shima091824-collab/pokota-tools/gps-cat-tracker/BOM.md

# GPS Cat Tracker LoRa v3n — BOM (Bill of Materials)

> **基板**: 30 × 35 mm（充電回路搭載版・503035バッテリー対応）
> **通信**: E220-900T22S(JP) LoRa 920MHz 技適済 (001-P01730)
> **設計ファイル**: `lora-30x35-v3n.kicad_pcb`
> **ピン配置**: 全部品データシート＋KiCadライブラリで確認済み (2026-05-26)
> **v3n追加 (2026-05-28)**: USB-C充電回路 + TP4056 + MSK12C02電源SW + LED×2

---

## v3n 変更点（v3m からの追加）

| 追加内容 | 詳細 |
|---|---|
| 基板サイズ | 30×28mm → **30×35mm**（バッテリーと同フットプリント） |
| USB-C充電 | SMDエッジマウント（VBUS/GND/CC1/CC2） |
| 充電IC | TP4056 SOT-23-8（5kΩ PROG → 200mA充電） |
| 電源SW | MSK12C02 SPDT（BATT+とE220 VCCを切断） |
| 充電LED | 赤（充電中）・青（充電完了）各0402 |
| CC抵抗 | R5/R6 5.1kΩ × 2（USB-C CC1/CC2プルダウン） |
| バッテリー | **503035 LiPo（5×30×35mm 推定350mAh）** |

---

## ⚠️ v3 Plan-B 変更点（v2からの修正）

| 変更点 | v2（GPS無し） | v3 Plan-B |
|---|---|---|
| ボードサイズ | 30×22mm | **30×28mm**（GPS搭載のため拡大） |
| GPS | プレースホルダのみ | **MAX-M8Q 実装**（9.7×10.1mm） |
| GPS footprint | 4.1×3.1mm（**誤り**） | **9.7×10.1mm**（データシート実測値） |
| GPSパッドピッチ | 0.35mm（推定、誤り） | **1.1mm**（データシートTable21 E値） |
| 重量（目安） | 約5〜6g | **約8〜9g** |
| バッテリ寿命 | LoRaのみ約214日 | **GPS+LoRa 約10日** |

### v2からの継続事項（変更なし）
| 項目 | 内容 |
|---|---|
| E220ピン配置 | データシート確認済み：短辺22ピンDFN |
| ATtiny3226ピン配置 | データシート確認済み：VQFN-20 セクション2.3 |
| GPS電圧 | 3.3V直接接続（VIO_SEL=開放で3.3Vモード） |
| 充電回路 | 削除済み（外付け充電器で充電） |
| 電源 | E220 VDD(pin15)=3.3V出力を活用（LDO不要） |
| GPSアンテナ | IPEX/U.FLコネクタ経由で外付けGPSパッチアンテナ接続 |

---

## 主要部品

### 既存部品（v3m から継続）

| Ref | 部品名 | 型番 | 調達先候補 | 数量 | 単価(目安) | 備考 |
|-----|---|---|---|---|---|---|
| U1 | LoRaモジュール | E220-900T22S(JP) | 秋月/Amazon/千石 | 1 | ¥2,500 | 技適✅ 001-P01730, 26×16mm DFN-22 |
| U2 | MCU | ATtiny3226-MFR | Mouserほか | 1 | ¥220 | VQFN-20 3×3mm, UART×2, 1.8-5.5V |
| U3 | GPS | MAX-M8Q-00B | Mouserほか | 1 | ¥800 | **9.7×10.1mm LCC-18**, 3.3V対応, -148dBm |
| J1 | バッテリコネクタ | JST-GH 1.25mm 2P | 秋月 | 1 | ¥60 | SMD横差し |
| C1–C4 | コンデンサ 100nF 0402 | — | JLCPCB Basic | 4 | ¥3 | 電源デカップリング |
| C5 | コンデンサ 1μF 0402 | — | JLCPCB Basic | 1 | ¥5 | 3.3Vバルクキャップ |
| R1 | 抵抗 10kΩ 0402 | — | JLCPCB Basic | 1 | ¥2 | E220 AUXプルアップ（オプション） |

### v3n 追加部品

| Ref | 部品名 | 型番 | 調達先候補 | 数量 | 単価(目安) | 備考 |
|-----|---|---|---|---|---|---|
| J2 | USB-C充電コネクタ | TYPE-C-31-M-12 等 | AliExpress/秋月 | 1 | ¥100 | SMDエッジマウント |
| U4 | 充電IC | TP4056 | AliExpress/JLCPCB | 1 | ¥50 | SOT-23-8, 5V入力→LiPo充電 |
| SW1 | 電源スイッチ | MSK12C02 | AliExpress | 1 | ¥30 | SPDT スライド, 4×3mm |
| LED1 | 充電中LED（赤） | 0402 RED | JLCPCB Basic | 1 | ¥3 | 充電中点灯 |
| LED2 | 充電完了LED（青） | 0402 BLUE | JLCPCB Basic | 1 | ¥3 | 満充電で点灯 |
| R2 | PROG抵抗 | 5kΩ 0402 | JLCPCB Basic | 1 | ¥2 | 充電電流 1000/5000=**200mA** |
| R3 | LED電流制限 | 330Ω 0402 | JLCPCB Basic | 1 | ¥2 | LED1用 |
| R4 | LED電流制限 | 330Ω 0402 | JLCPCB Basic | 1 | ¥2 | LED2用 |
| R5 | CC1プルダウン | 5.1kΩ 0402 | JLCPCB Basic | 1 | ¥2 | USB-C規格準拠（必須） |
| R6 | CC2プルダウン | 5.1kΩ 0402 | JLCPCB Basic | 1 | ¥2 | USB-C規格準拠（必須） |
| C6 | バイパスコンデンサ | 100nF 0402 | JLCPCB Basic | 1 | ¥3 | TP4056 VCC直近 |
| — | LiPoバッテリー | **503035** | AliExpress/Amazon | 1 | ¥700 | 5×30×35mm 推定300〜400mAh |

---

## 電源アーキテクチャ（LDO不要！）

```
LiPo 3.7V ──→ J1(BATT+) ──→ E220 VCC (pin10, 2.2-5.5V対応)
                                    │
                              E220内蔵LDO
                                    │
                              E220 VDD (pin15) = 3.3V出力（最大100mA）
                                    │
                    ┌───────────────┼───────────────┐
                    ↓               ↓               ↓
              ATtiny VDD(pin4)  GPS VCC(pin8)   GPS V_IO(pin7)
              ATtiny電源(3.3V)  GPS電源(3.3V)   GPS IOレベル(3.3V)
```

**GPS VIO_SEL (pin15) = 開放 → V_IO = VCC = 3.3V**（3.3Vモード自動選択）

---

## 確認済みピン配置（全てデータシート実測値）

### E220-900T22S(JP) — データシート Rev2.1.1 セクション3.1

| ピン | 信号名 | 接続先 |
|---|---|---|
| 1-3 | AGND | GND（RF側） |
| 4 | GND | GND |
| 5 | M0 | ATtiny PA4 (VQFN pin5) |
| 6 | M1 | ATtiny PA5 (VQFN pin6) |
| 7 | RXD | ATtiny PB2/USART0-TxD (VQFN pin12) |
| 8 | TXD | ATtiny PB3/USART0-RxD (VQFN pin11) |
| 9 | AUX | ATtiny PA6 (VQFN pin7)、入力 |
| 10 | VCC | BATT+ (3.7V LiPo) |
| 11 | GND | GND |
| 12 | SWDIO | 未接続（FW更新用） |
| 13 | SWGND | GND（FW更新時のみ） |
| 14 | SWCLK | 未接続（FW更新用） |
| 15 | VDD | **3.3V出力** → ATtiny/GPS電源 |
| 16-18 | NC | 開放 |
| 19 | GND | GND |
| 20 | AGND | GND（RF側） |
| 21 | ANT | IPEXコネクタ（アンテナ接続） |
| 22 | AGND | GND（RF側） |

### ATtiny3226 VQFN-20 — DS40002345A セクション2.3

| ピン | 信号名 | 接続先 |
|---|---|---|
| 1 | PA2 | 未使用 |
| 2 | PA3 | 未使用 |
| 3 | GND | GND |
| 4 | VDD | 3.3V（E220 VDD） |
| 5 | PA4 | E220 M0 (pin5) |
| 6 | PA5 | E220 M1 (pin6) |
| 7 | PA6 | E220 AUX (pin9) |
| 8 | PA7 | 未使用 |
| 9 | PB5 | 未使用 |
| 10 | PB4 | 未使用 |
| 11 | PB3/USART0-RxD | E220 TXD (pin8) |
| 12 | PB2/USART0-TxD | E220 RXD (pin7) |
| 13 | PB1 | 未使用 |
| 14 | PB0 | 未使用 |
| 15 | PC0 | 未使用 |
| 16 | PC1/USART1-RxD★ | GPS TXD (pin2) ★PORTMUX要設定 |
| 17 | PC2/USART1-TxD★ | GPS RXD (pin3) ★PORTMUX要設定 |
| 18 | PC3 | 未使用 |
| 19 | PA0/UPDI | プログラミング端子 |
| 20 | PA1 | 未使用 |
| EP | GND | GND（熱パッド、接続必須） |

★PORTMUX設定: `PORTMUX.USARTROUTEA |= PORTMUX_USART1_ALT1_gc;` （USART1をPC1/PC2に割り当て）

### MAX-M8Q LCC-18 — 9.7×10.1mm（データシート UBX-15031506-R06 Table11確認済み）

> **パッド仕様（KiCadオフィシャルライブラリ ublox_MAX.kicad_mod + DS確認済み）**
> - 9パッド/辺（長辺10.1mm = Y方向側）
> - ピッチ E=1.1mm（DS Table11確認済み）
> - 端から1番目パッドまで D=0.65mm（DS確認済み）
> - パッドサイズ: **1.8mm × 0.8mm**（角パッド1,9,10,18は1.8mm × 0.7mm）
> - パッドX位置: ±4.75mm（KiCadライブラリ実測値）
> - **EP（サーマルパッド）なし**（LCC-18は側面パッドのみ）
> - 動作電圧: VCC/VCC_IO = 2.7〜3.6V（typ 3.0V）→ 3.3V接続✓
> - 重量: **0.6g**（DS確認済み）

| ピン | 信号名（M8Q） | 接続先 |
|---|---|---|
| 1 | GND | GND |
| 2 | TXD | ATtiny PC1/USART1-RxD (pin16) |
| 3 | RXD | ATtiny PC2/USART1-TxD (pin17) |
| 4 | TIMEPULSE | 未使用（開放） |
| 5 | EXTINT | 未使用（開放） |
| 6 | V_BCKP | VCC(3.3V)に接続（RTC維持） |
| 7 | **VCC_IO** | 3.3V（E220 VDD）※M8QではV_IOではなくVCC_IO |
| 8 | VCC | 3.3V（E220 VDD） |
| 9 | RESET_N | 未使用（開放）内部プルアップあり |
| 10 | GND | GND |
| 11 | RF_IN | IPEX/U.FLコネクタ → 外付けGPSパッチアンテナ |
| 12 | GND | GND |
| 13 | LNA_EN | 未使用（開放）※M8Q/Cでアンテナ制御可能 |
| 14 | VCC_RF | 未使用（開放） |
| 15 | **Reserved** | **開放（M8Qでは未接続）** ※M10SのVIO_SELとは全く別！ |
| 16 | SDA | 未使用（開放） |
| 17 | SCL | 未使用（開放） |
| 18 | SAFEBOOT_N | 未使用（開放）内部プルアップあり |

**⚠️ M8QとM10Sの違い:**
- pin7: M8Q=**VCC_IO** / M10S=V_IO（どちらも3.3V接続）
- pin15: M8Q=**Reserved**（開放）/ M10S=VIO_SEL（開放で3.3V選択）
- 動作電圧: M8Q=2.7〜3.6V / M10S=1.71〜1.89V（VIO_SEL=openで3.3V I/Oモード）

---

## ★ 発注前の必須確認事項

- [x] **GPSフットプリント寸法確認済み**
  - DS Table11: A=10.1mm, B=9.7mm, E=1.1mm(ピッチ), D=0.65mm(端〜1番パッド) 確認済み
  - KiCad公式ライブラリ(ublox_MAX.kicad_mod): pad=1.8×0.8mm, X=±4.75mm 確認済み
  - EP（サーマルパッド）なし 確認済み
- [ ] **IPEX/U.FLコネクタをKiCadに手動追加**（GPS pin11=RF_IN接続用）
  - 推奨: Hirose U.FL-R-SMT-1(10) または同等品
  - 配置: GPS左辺(pin11)近傍、基板左寄り
- [ ] KiCad DRC（`検査 > デザイン ルール チェッカー`）エラーゼロ確認
- [ ] E220フットプリント: パッドピッチ1.27mm確認済み（データシートより）✓
- [ ] ATtiny3226 QFN-20: 0.5mmピッチ → **外注推奨**（手はんだ難）
- [ ] MAX-M8Q LCC-18: 1.1mmピッチ → **外注推奨**（細密）
- [ ] GPS外付けアンテナ選定・調達（1575.42MHz パッシブGPS対応）
  - 候補: Taoglas FXP.35 フレキシブルパッチアンテナ（小型軽量）
  - または: 汎用GPSパッチアンテナ + U.FLケーブル（100〜200円）

---

## PCB発注（JLCPCB）

| 項目 | 仕様 |
|---|---|
| 基板サイズ | 30 × 28 mm |
| 層数 | 2層 |
| 厚さ | 0.8mm（軽量化） |
| 銅箔 | 1oz |
| 表面仕上げ | HASL（鉛なし） |
| ソルダーマスク | 緑 |
| 枚数 | 5枚（最小ロット） |
| **PCB代（目安）** | **約$2〜3（OCS NEP送料込み）** |

**アップロードファイル**: `gerber-v3b/lora-30x28-v3b-gerber.zip`

---

## バッテリ（別途調達）

| 品名 | 寸法 | 価格 |
|---|---|---|
| LiPo 300mAh 3.7V | 5×30×28mm以内 | ¥600〜900 |

外付けUSBchargerでバッテリーを充電

---

## 重量・バッテリ寿命

| 項目 | 値 | 出典 |
|---|-----|---|
| PCB重量目安 | 約3.5g（30×28mm） | 推定 |
| GPS モジュール | **0.6g** | DS Table11実測値 |
| バッテリ（300mAh） | 約5g | 仕様 |
| アンテナ+U.FLケーブル | 約1g | 推定 |
| **合計** | **約10〜11g** | |

### 消費電流（MAX-M8Q、3.0V動作）— DS Table10実測値

| モード | 電流 | 条件 |
|---|---|---|
| GPS 取得中 | **26mA** | Acquisition（start〜first fix） |
| GPS 連続追跡 | **23mA** | Tracking Continuous mode |
| GPS 省電力追跡 | **6.2mA** | Tracking Power Save 1Hz mode |
| LoRa 送信 | 43mA | 13dBm（E220 DS） |
| スリープ | <7.5µA | ATtiny3226(<5µA) + E220 DeepSleep(2.5µA) |

### バッテリ寿命計算（30分間隔、300mAh）

| GPS動作モード | 計算式 | 寿命 |
|---|---|---|
| 連続追跡（60秒GPS+2秒LoRa） | 26mA×15s + 23mA×45s + 43mA×2s = 20.5mAh/日 | **約14日** |
| 省電力1Hz（60秒GPS+2秒LoRa） | 26mA×10s + 6.2mA×50s + 43mA×2s = 8.9mAh/日 | **約34日** |

> 省電力モードはATtinyからGPS EXTINT(pin5)でコントロール可能（PowerSave設定）

---

## ホーム受信機（別途構築）

猫が帰宅/外出した際のLoRa信号受信用

| 部品 | 型番 | 価格 |
|---|---|---|
| Raspberry Pi Zero W | — | ¥2,000〜 |
| E220-900T22S(JP) | 同型 | ¥2,500 |
| USBシリアル変換 | CP2102など | ¥500 |
| 外付けアンテナ | 920MHz対応 | ¥500 |
| **合計** | | **¥5,500〜** |

---

## 総コスト（初回）

| 項目 | 金額 |
|---|---|
| JLCPCB PCB（5枚） | ¥450 |
| E220-900T22S(JP) × 1 | ¥2,500 |
| ATtiny3226 × 1 | ¥220 |
| MAX-M8Q × 1 | ¥800 |
| JST-GH + コネクタ | ¥60 |
| パッシブ部品一式 | ¥100 |
| GPSチップアンテナ | ¥200〜 |
| バッテリ 300mAh | ¥700 |
| はんだ付け外注（GPS/MCU） | ¥3,000〜 |
| **合計（初回）** | **約¥8,000〜** |

---

*設計: Claude Code / Anthropic — v3c Plan-B 2026-05-26*
*全ピン配置・footprint寸法はデータシート+KiCadオフィシャルライブラリで確認済み。*
*MAX-M8Q DS: UBX-15031506-R06 | KiCad lib: ublox_MAX.kicad_mod | E220 DS: Rev2.1.1*
