shima091824-collab/pokota-tools/traccar/templates/export/devices.xlsx

Report type: | Devices
Name | Unique ID | Phone | Model | Contact | Status | Last Update | Address
${item.device.name} | ${item.device.uniqueId} | ${item.device.phone} | ${item.device.model} | ${item.device.contact} | ${item.device.status} | ${dateTool.format("YYYY-MM-dd HH:mm:ss", item.device.lastUpdate, locale, timezone)} | ${item.position.address}
