shima091824-collab/pokota-tools/lte-m-cat-tracker/kicad/_restore_backup_2026-06-12T14-10-30-185/lte-m-cat-tracker.kicad_pcb

## KiCad design lte-m-cat-tracker/kicad/_restore_backup_2026-06-12T14-10-30-185/lte-m-cat-tracker.kicad_pcb (2026-06-12)

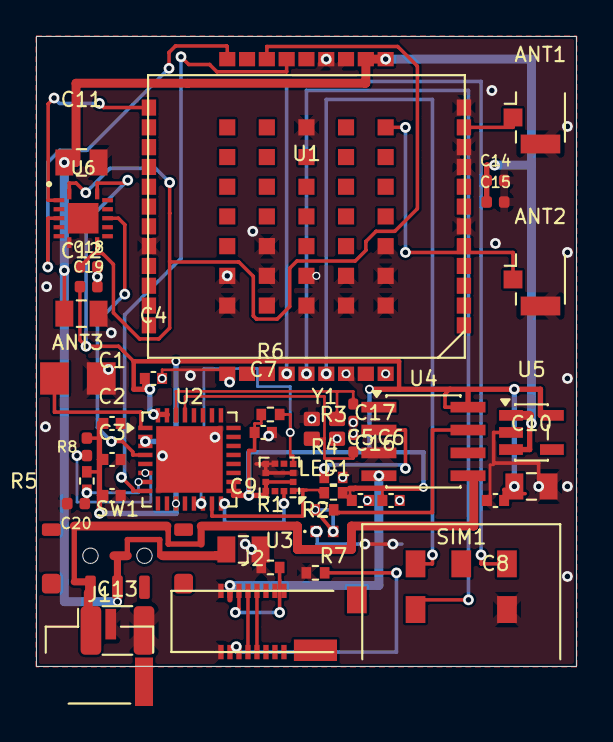
[picture p1: board lte-m-cat-tracker.kicad_pcb from above]

Board: 2 copper layers, 30.0 x 35.0 mm, 43 parts (0 on the bottom side), 34 nets.

Parts:
ANT1: U.FL-LTE
ANT2: U.FL-GNSS
ANT3: RFANT3216120A5T; ChipAntenna_1206
C1, C2, C3, C4, C5, C6, C7, C8: 100nF
C9, C10, C11, C12: 10uF
C13: 100uF_6.3V_PolymerAl; C_1210_3225Metric
C14, C15, C18, C19, C20: 100nF; C_0402
C16, C17: 18pF
J1: JST-GH-1.25mm-2P
J2: USB-C-16P
LED1: RED
R1, R2: 5.1k
R3: 3.3k
R4: 1k
R5: 10k
R6, R7: 4.7k
R8: 10k; C_0402
SIM1: SMN-305
SW1: MSK12C02-HB
U1: SIM7080G-M
U2: ESP32-C3
U3: LIS2DW12TR
U4: TP4056
U5: XC6220B331MR-G
U6: TXB0104RGYR; TXB0104_RGY14
Y1: 7D040000M01 40MHz 12pF

Connections:
+3.3V: C1.1, C2.1, C3.1, C4.1, C5.1, C6.1, C7.1, C8.1, C10.1, C19.1, R5.2, R6.1, R7.1, R8.2, U2.2, U2.3, U2.11, U2.17, U2.18, U2.31, U2.32, U3.2, U3.9, U3.10, U4.8, U5.5, U6.14
ACCEL_INT1: U2.16, U3.12
CC1: J2.A5, R1.2
CC2: J2.B5, R2.2
CHIP_EN: C20.1, R5.1, U2.7
CHRG: R4.2, U4.7
ESP_GPIO2: R8.1, U2.6
GND: ANT1.2, ANT2.2, ANT3.2, C1.2, C2.2, C3.2, C4.2, C5.2, C6.2, C7.2, C8.2, C9.2, C10.2, C11.2, C12.2, C13.2, C14.2, C15.2, C16.1, C17.2, C18.2, C19.2, C20.2, J1.2, J2.A1, J2.B1, LED1.1, R1.1, R2.1, R3.2, SIM1.5, U1.8, U1.13, U1.19, U1.21, U1.27, U1.30, U1.31, U1.33, U1.36, U1.37, U1.45, U1.63, U1.66, U1.67, U1.69, U1.70, U1.71, U1.72, U1.73, U1.74, U1.75, U1.76, U1.77, U2.33, U3.3, U3.6, U3.7, U3.8, U4.3, U5.2, U6.7, U6.15, Y1.2, Y1.4
GNSS_ANT: ANT2.1, U1.68
I2C_SCL: R7.2, U2.15, U3.1
I2C_SDA: R6.2, U2.14, U3.4
LED_ANODE: LED1.2, R4.1
LTE_ANT: ANT1.1, U1.32
PROG: R3.1, U4.2
SIM_CLK: SIM1.3, U1.16
SIM_DATA: SIM1.2, U1.15
SIM_PWRKEY: U1.39, U2.8
SIM_RST: SIM1.4, U1.17
SIM_RXD: U1.2, U6.3
SIM_RXD_33: U2.28, U6.12
SIM_STATUS: U1.42, U6.4
SIM_STATUS_33: U2.4, U6.11
SIM_TXD: U1.1, U6.2
SIM_TXD_33: U2.27, U6.13
SIM_VDD: SIM1.1, U1.18
USB_DN: J2.A7, J2.B7, U2.25
USB_DP: J2.A6, J2.B6, U2.26
VBAT: C13.1, J1.1, SW1.1, U4.5
VBAT_SW: C9.1, C11.1, C12.1, C14.1, C15.1, SW1.2, U1.34, U1.35, U5.1, U5.3
VDD_EXT: C18.1, U1.40, U6.1, U6.8
VUSB: J2.A4, U4.4
WIFI_ANT: ANT3.1, U2.1
XTAL_N: C16.2, U2.29, Y1.1
XTAL_P: C17.1, U2.30, Y1.3
