shima091824-collab/pokota-tools/gps-cat-tracker/lora-30x28-v3m_netted.kicad_pcb

## KiCad design gps-cat-tracker/lora-30x28-v3m_netted.kicad_pcb (2026-06-05)

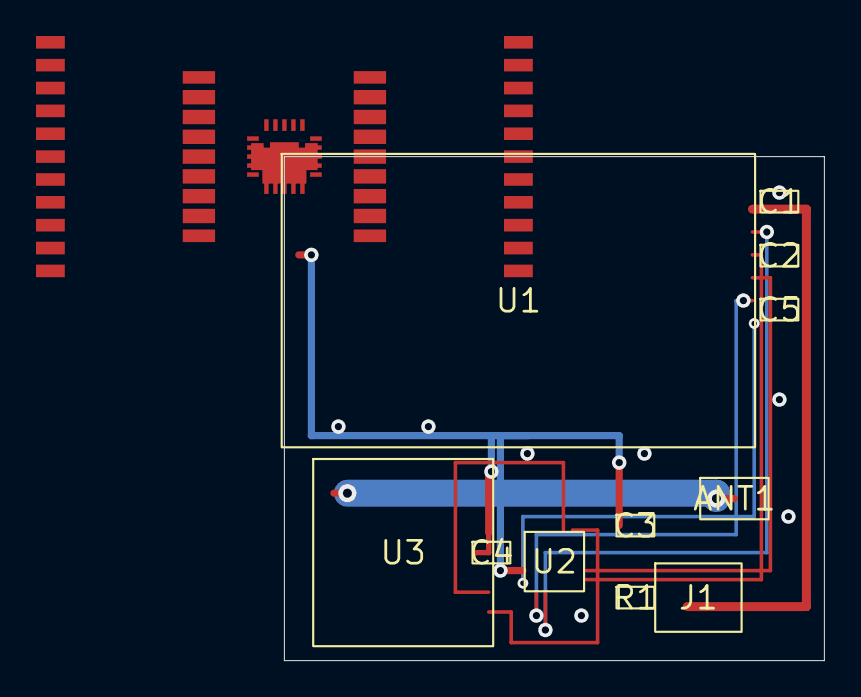
[picture p2: board lora-30x28-v3m_netted.kicad_pcb from above]

Board: 2 copper layers, 30.0 x 28.0 mm, 11 parts (0 on the bottom side), 9 nets.

Parts:
ANT1: U.FL-R-SMT_IPEX
C1, C2, C3, C4: 100nF
C5: 1uF
J1: JST-GH_1.25mm_2P
R1: 10k
U1: E220-900T22S(JP)
U2: ATtiny3226-MFR_VQFN20
U3: MAX-M8Q-00B_LCC18

Connections:
AUX: U1.9, U2.7
M0: U1.5, U2.5
M1: ANT1.G2, C2.1, C5.1, U1.6, U1.8, U2.6, U2.11
Net-011: ANT1.G1, ANT1.S
Net-020: C1.1, J1.1, J1.2, U1.10
Net-026: C3.1, C4.1, U2.4, U3.4, U3.5, U3.6, U3.7, U3.8, U3.9
Net-037: U1.7, U2.12
UART1_RX: U2.17, U3.3
UART1_TX: U2.16, U3.2
