shima091824-collab/pokota-tools/gps-cat-tracker/lora-30x22-routed.kicad_pcb

## KiCad design gps-cat-tracker/lora-30x22-routed.kicad_pcb (2026-05-26)

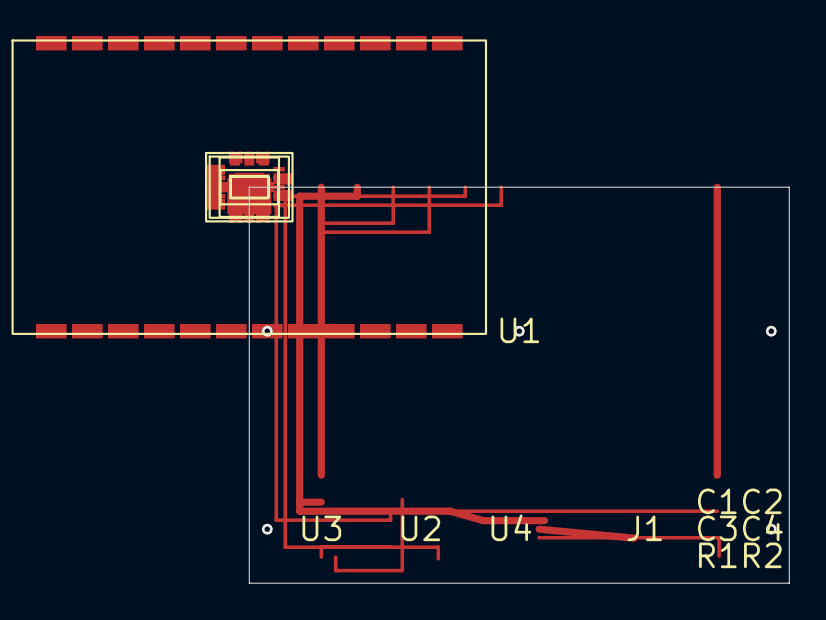
[picture p3: board lora-30x22-routed.kicad_pcb from above]

Board: 2 copper layers, 30.0 x 22.0 mm, 11 parts (0 on the bottom side), 9 nets.

Parts:
C1, C2, C3, C4: 100nF
J1: JST-GH_1.25mm_2P
R1: 4.7k
R2: 10k
U1: E220-900T22S(JP)
U2: ATtiny3226
U3: MAX-M10S
U4: MCP73831T

Connections:
BATT_P: J1.1, U4.3
CHARGE_PROG: R1.1, U4.4
E220_AUX: R2.2, U1.7
GND: C1.2, C2.2, C3.2, C4.2, J1.2, R1.2, U1.1, U1.8, U1.9, U1.10, U1.11, U1.12, U1.13, U1.14, U1.15, U1.16, U1.17, U1.18, U1.19, U1.20, U1.21, U1.22, U1.23, U1.24, U2.1, U2.2, U2.3, U2.4, U2.7, U2.8, U2.9, U2.12, U2.13, U2.14, U2.15, U2.17, U2.18, U2.19, U2.20, U2.EP, U3.1, U3.5, U3.6, U3.7, U3.8, U3.9, U3.10, U3.EP, U4.1, U4.2
GPS_RXD: U2.10, U3.2
GPS_TXD: U2.11, U3.3
UART_RX: U1.6, U2.6
UART_TX: U1.5, U2.5
VCC_3V3: C1.1, C2.1, C3.1, C4.1, R2.1, U1.2, U2.16, U3.4, U4.5
