shima091824-collab/pokota-tools/lte-m-cat-tracker/kicad/verify_u3fix.py

#!/usr/bin/env python3
"""U3ネット修正の追加ルート一括検証。リップ対象を除外した既存要素と照合。"""
import check_route as cr

items = cr.load(cr.PCB)

RIP_SEGS = {  # (x1,y1,x2,y2)
    (11.8,23.0,13.25,23.0),(13.25,23.0,13.25,23.738),(13.25,23.738,13.3,23.738),
    (13.3,23.738,13.3,24.25),(11.8,25.5,10.95,25.5),(11.8,25.5,12.738,25.5),
    (12.738,25.5,12.738,25.25),(10.95,25.5,10.95,25.25),(11.8,19.6,11.8,25.5),
    (13.2,26.5,13.2,24.75),(13.2,24.75,12.738,24.75),
    (9.15,25.95,9.15,29.55),(9.15,29.55,13.3,29.55),(13.3,29.55,13.3,29.15),
    (13.3,29.15,16.8,29.15),(16.8,29.15,16.8,29.225),(16.8,29.225,14.875,29.225),
    (14.875,29.225,14.875,23.4),(14.875,23.4,15.5,23.4),(15.5,23.4,13.65,23.4),
    (13.65,23.4,13.75,23.4),(13.75,23.4,13.75,23.7375),(13.35,21.6,15.5,21.6),
    (15.5,21.6,15.5,23.4),(13.35,21.0,13.35,21.6),
    (14.2625,24.25,14.2625,25.25),(14.2625,25.25,14.2625,29.85),
    (14.2625,29.85,10.85,29.85),(10.85,29.85,10.85,25.95),
    (12.7375,23.75,12.2,23.75),(14.2625,23.75,14.95,23.75),
    (2.0,27.2,14.5,27.2),(14.5,27.2,14.5,28.5),
}
RIP_VIAS = {(11.8,23.0),(11.8,25.5),(11.8,19.6),(9.15,29.55),(16.8,29.225),(15.5,23.4),(12.9,22.2)}

def ripped(it):
    if it[0]=='seg':
        a=(it[3],it[4],it[5],it[6]); b=(it[5],it[6],it[3],it[4])
        return a in RIP_SEGS or b in RIP_SEGS
    if it[0]=='via':
        return (it[3],it[4]) in RIP_VIAS
    return False

# パッドのネットも変わる: U3 pads再割当を items に反映（照合用）
NEWNET = {'U3.1':'I2C_SCL','U3.3':'GND','U3.4':'I2C_SDA','U3.7':'GND','U3.8':'GND',
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
# GND: 中央橋 pad3↔pad8 + pad8-pad7列 + 島9代替via
c+=[(S,'GND','F.Cu',12.7375,24.75,14.2625,24.75,0.2),
    (S,'GND','F.Cu',14.2625,24.75,14.2625,25.25,0.2),
    (V,'GND',16.3,22.6)]

bad = cr.check(c, fixed, 'u3fix')
print(f'\n違反 {len(bad)} 件:')
for b in sorted(set(bad)): print(' ', b)
