shima091824-collab/pokota-tools/lte-m-cat-tracker/kicad/verify_u3rot.py

#!/usr/bin/env python3
"""U3 180°回転＋ネット再割当の新規ルート一括検証。"""
import check_route as cr

items = cr.load(cr.PCB)

RIP_SEGS = {
    # +3.3V 旧pad2/pad12系の枝（給電先消滅）
    (11.8,23.0,13.25,23.0),(13.25,23.0,13.25,23.738),(13.25,23.738,13.3,23.738),
    (13.3,23.738,13.3,24.25),(13.3,24.25,12.7375,24.25),
    # SCL旧pad3タップ
    (13.2,26.5,13.2,24.75),(13.2,24.75,12.738,24.75),
    # SDA東ループ全部
    (9.15,25.95,9.15,29.55),(9.15,29.55,13.3,29.55),(13.3,29.55,13.3,29.15),
    (13.3,29.15,16.8,29.15),(16.8,29.15,16.8,29.225),(16.8,29.225,14.875,29.225),
    (14.875,29.225,14.875,23.4),(14.875,23.4,15.5,23.4),(15.5,23.4,13.65,23.4),
    (13.65,23.4,13.75,23.4),(13.75,23.4,13.75,23.7375),
    (13.35,21.0,13.35,21.6),(13.35,21.6,15.5,21.6),(15.5,21.6,15.5,23.4),
    # ACCEL旧
    (14.2625,24.25,14.2625,25.25),(14.2625,25.25,14.2625,29.85),
    (14.2625,29.85,10.85,29.85),(10.85,29.85,10.85,25.95),
    # GND旧スタブ（pin4/pin12位置になるもの）
    (14.2625,23.75,14.95,23.75),(13.75,25.2625,13.75,25.9),
}
RIP_VIAS = {(11.8,23.0),(9.15,29.55),(16.8,29.225),(15.5,23.4),(14.2625,25.25)}

def ripped(it):
    if it[0]=='seg':
        return (it[3],it[4],it[5],it[6]) in RIP_SEGS or (it[5],it[6],it[3],it[4]) in RIP_SEGS
    if it[0]=='via':
        return (it[3],it[4]) in RIP_VIAS
    return False

# U3 180°回転後のパッド位置と新ネット（global）
ROT = {  # pad: (x, y, net)
    '1': (14.2625,25.25,'I2C_SCL'), '2': (14.2625,24.75,'+3.3V'), '3': (14.2625,24.25,'GND'),
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
    (S,'ACCEL_INT1','B.Cu',13.75,27.0,13.75,25.95,0.2),
    (V,'ACCEL_INT1',13.75,25.95),
    (S,'ACCEL_INT1','F.Cu',13.75,25.95,13.75,25.2625,0.2)]

bad = cr.check(c, fixed, 'rot')
print(f'\n違反 {len(bad)} 件:')
for b in sorted(set(bad)): print(' ', b)
